ldgd2/Guitar-Hero-Band-Controller/(notices)

Notices in the files:
README.md:
License: OPEN HARDWARE
